Sebastianrmp/SIA_Extruder/Imagenes/PCB_DESIGN.jpeg

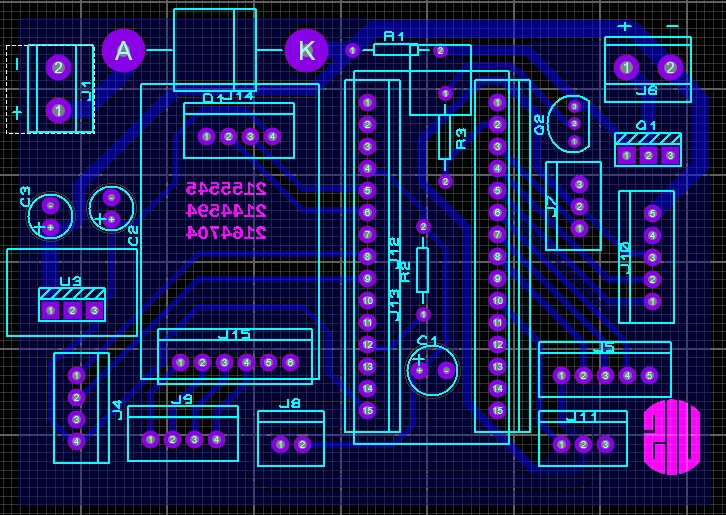
Imagenes/PCB_DESIGN.jpeg
