Sebastianrmp/SIA_Extruder/Imagenes/MONTAJE_FINAL_D.jpeg

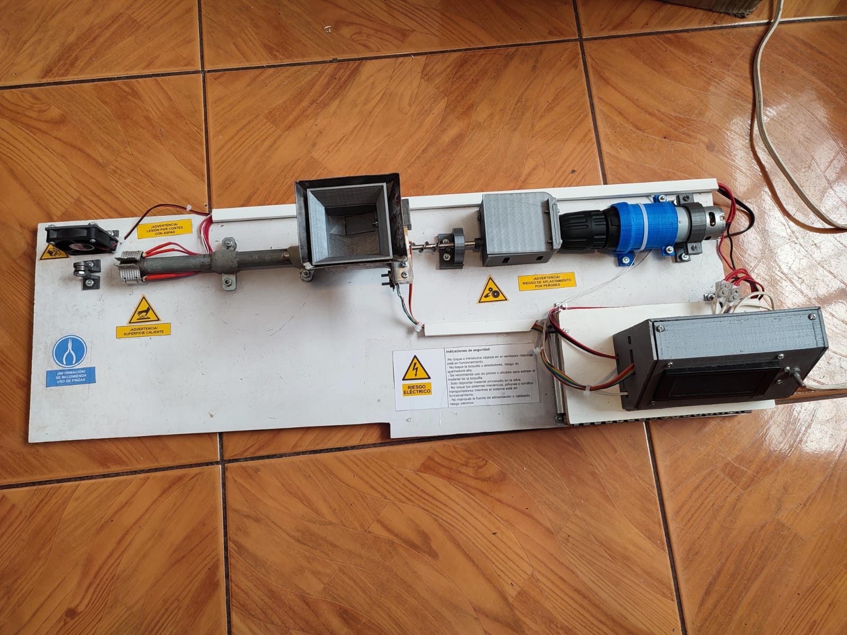
Imagenes/MONTAJE_FINAL_D.jpeg
