Sebastianrmp/SIA_Extruder/README.md

# Proyecto SIA Extruder
Project development for the SIA Extruder.
A add-on/extruder created by three Electronic Engineering students as a thesis project, based off of the idea of recycling plastic, either comercial or scraps from previous impressions to lower the impact the plastic has over the environment.
