Sebastianrmp/SIA_Extruder/Anexos/Extrusoras de Plástico .docx

Extrusoras de Plástico

En la industria, es muy común el uso de extrusoras de plástico para la elaboración de diversas piezas a partir de pellets, mediante la extrusión homogénea de plástico.

Las extrusoras se componen de un apartado de depósito de material, un apartado mecánico para el transporte y etapa de salida. El material pasa por una pieza que se calienta, dicha pieza tiene un orificio de salida por el cual el material fundido sale, ganando la forma del orificio.

Extrusión: la extrusión, es una técnica de fabricación mediante la fusión homogénea de termoplásticos.

Pellet: son pequeñas piezas de distintos materiales de un tamaño inferior a 5 mm, con forma irregular o esférica.

Existen varios tipos de extrusión de material plástico dentro de los cuales están:

Extrusión de tubería: El material triturado se deposita en una tolva sujeta a un ducto, dentro del cual hay un tornillo sin fin que transporta y compacta el material hasta el extremo donde se funde, dando así el resultado final .

Extrusión de película soplada: este método es muy popular, usado para la elaboración de bolsas o empaques, a diferencia de la extrusión de tubería, la salida pasa por un agujero que varía de unos centímetros a 3 metros, la cual pasa aire en medio

Extrusión de lámina:en este caso la salida del material fundido pasa por unos rodillos donde se enfría y estira para dejarlo como láminas.

Extrusión por-extrusión: este tipo de extrusión es usada para hacer recubrimiento plástico a cables, la salida tiene dos salidas que se unen una con el cable y la otra con el plástico.

Particularmente como las impresoras FDM usan filamento, por ello la manera de extrusión idónea es extrusión de tubería.

El material triturado se deposita en una tolva sujeta a un ducto, dentro del cual hay un tornillo sin fin que transporta y compacta el material hasta el extremo donde se funde y sale por un orificio, dando así como resultado un filamento del grosor del orificio.
