Sebastianrmp/SIA_Extruder/Imagenes/Driver.png

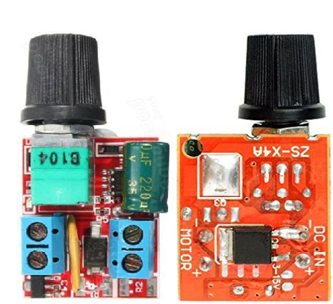
Imagenes/Driver.png
