Sebastianrmp/SIA_Extruder/Imagenes/IRFZ44N.jpeg

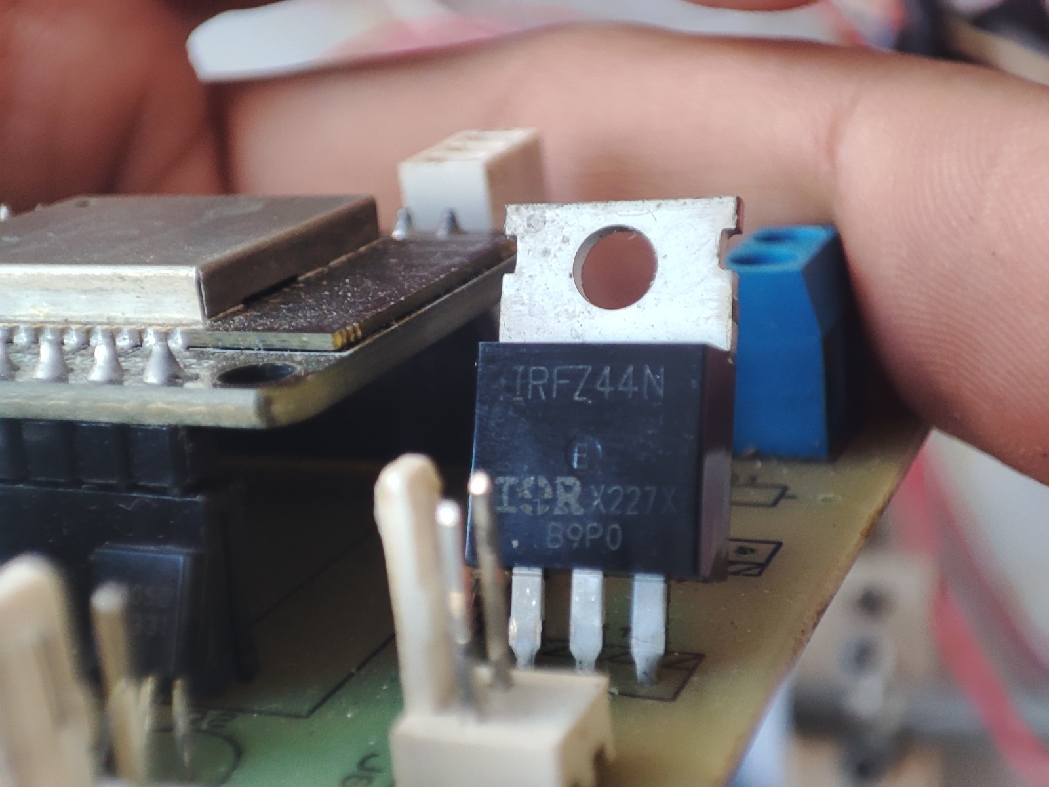
Imagenes/IRFZ44N.jpeg
