Sebastianrmp/SIA_Extruder/Imagenes/MEDIDOR_CORRIENTE.jpg

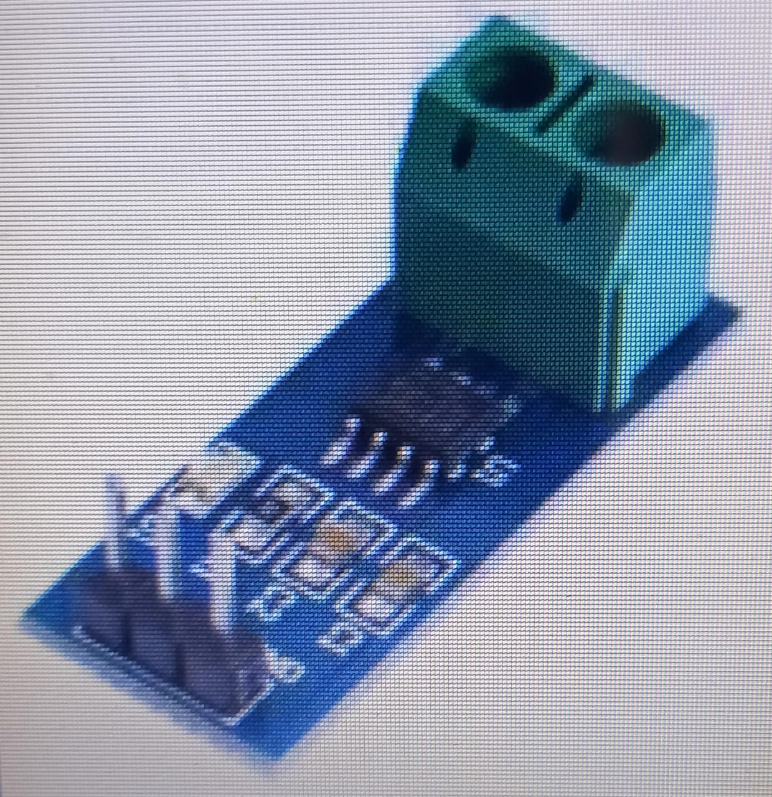
Imagenes/MEDIDOR_CORRIENTE.jpg
