Sebastianrmp/SIA_Extruder/Imagenes/PCB1.jpeg

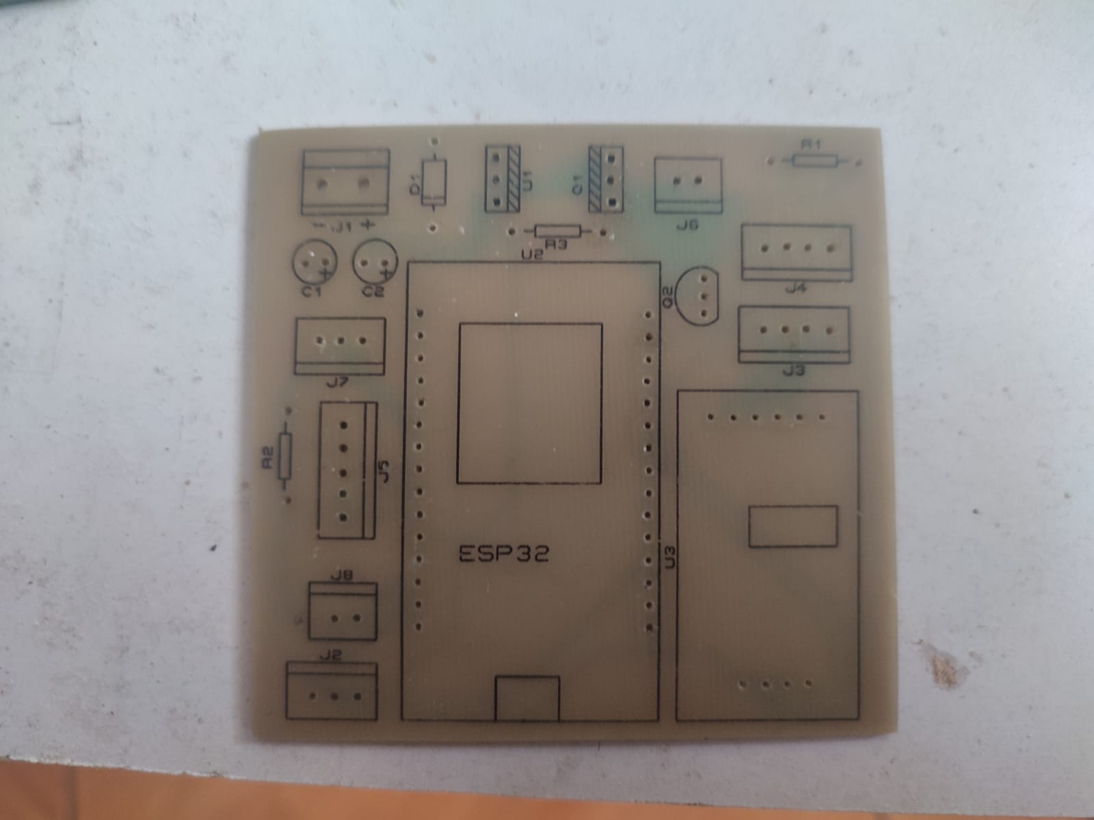
Imagenes/PCB1.jpeg
