Sebastianrmp/SIA_Extruder/Imagenes/PCB1_Montada.jpeg

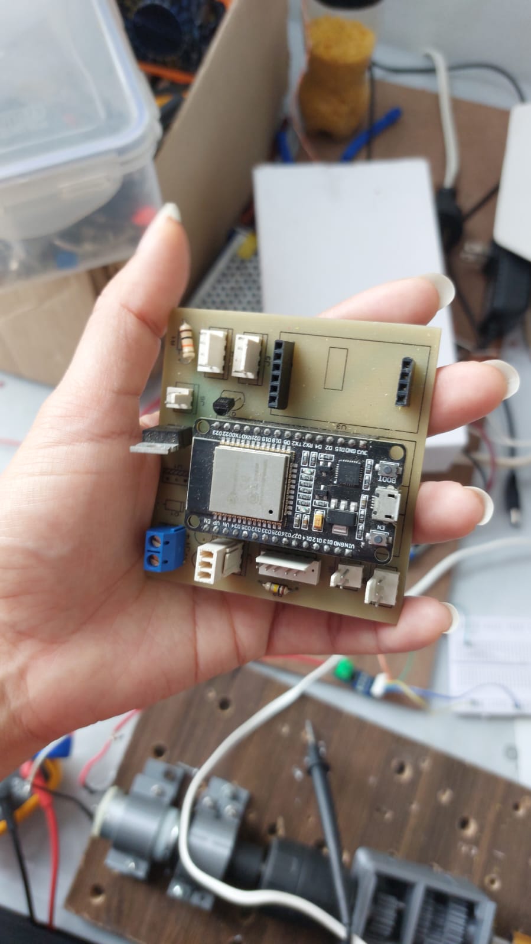
Imagenes/PCB1_Montada.jpeg
