Sebastianrmp/SIA_Extruder/Imagenes/PCB2.jpeg

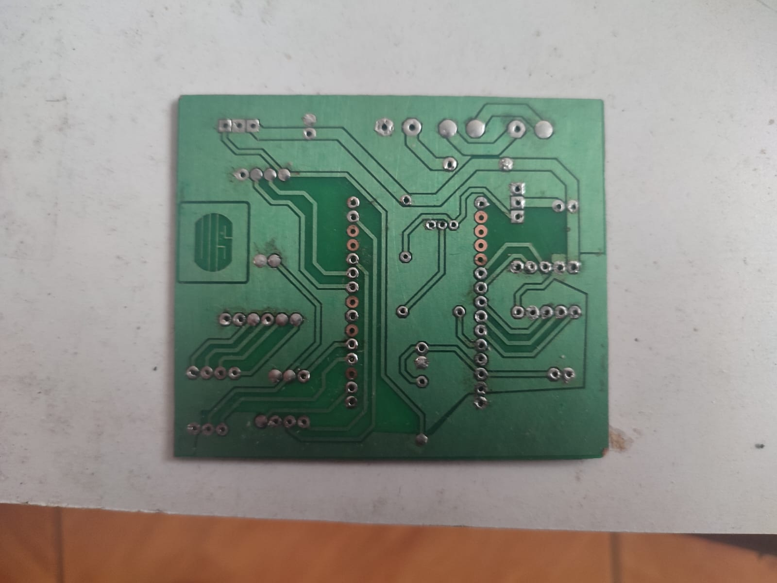
Imagenes/PCB2.jpeg
