Sebastianrmp/SIA_Extruder/Imagenes/PCB_FINAL.jpeg

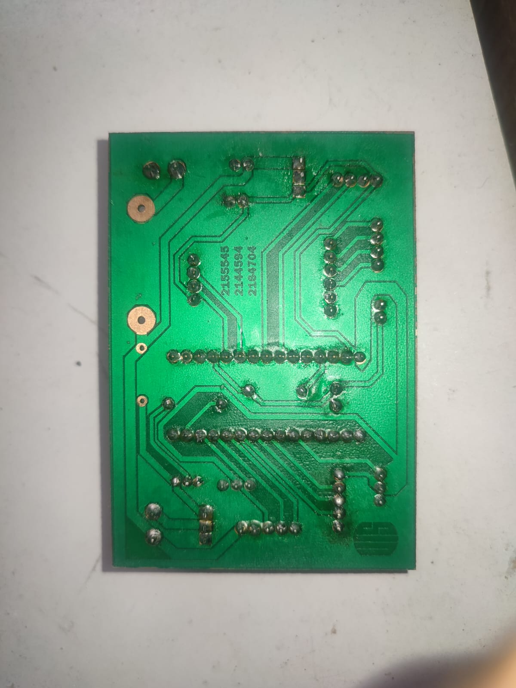
Imagenes/PCB_FINAL.jpeg
