Sebastianrmp/SIA_Extruder/Imagenes/S8050.jpeg

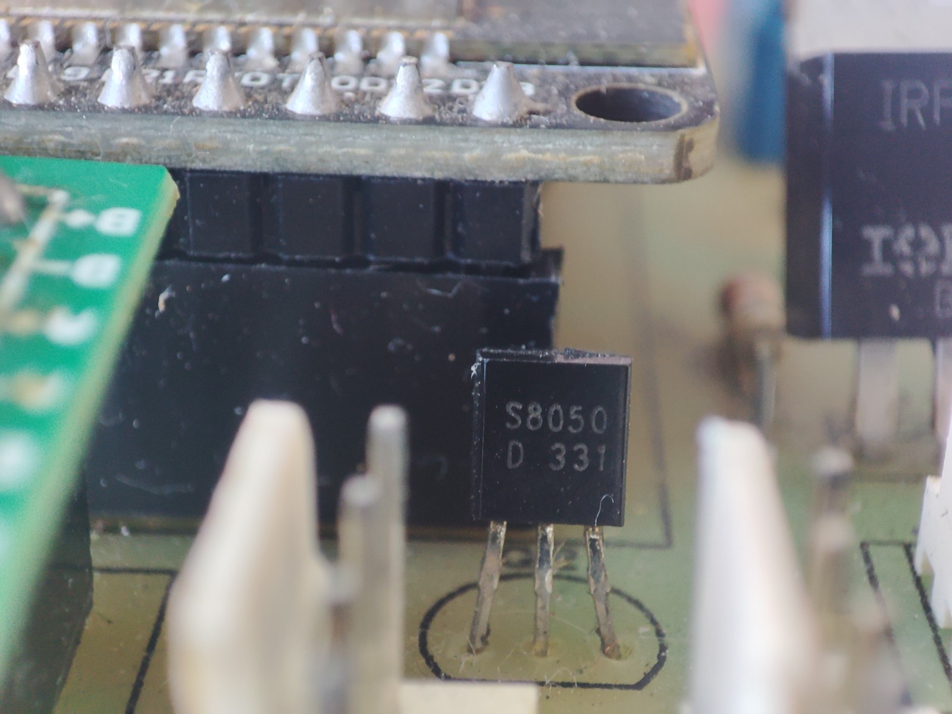
Imagenes/S8050.jpeg
