Sebastianrmp/SIA_Extruder/Scripts/Matlab/grafica_1.jpg

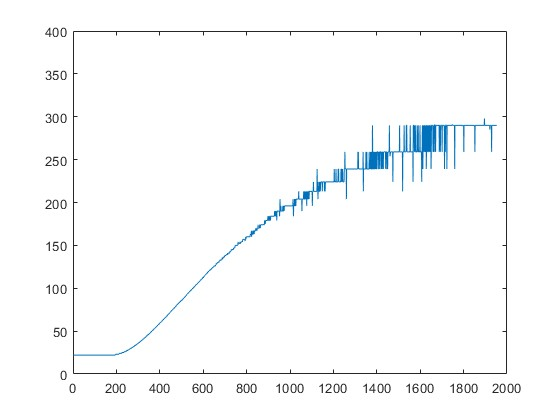
Scripts/Matlab/grafica_1.jpg
