Sebastianrmp/SIA_Extruder/Scripts/Matlab/grafica_2.jpg

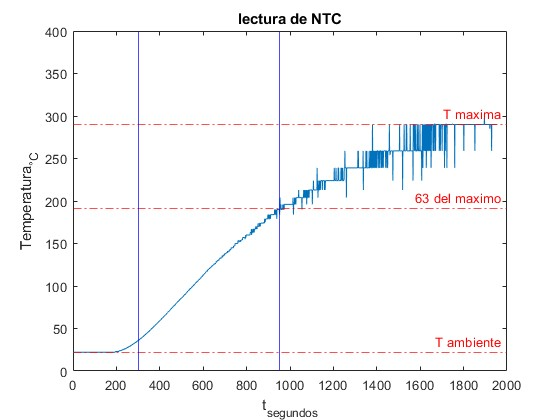
Scripts/Matlab/grafica_2.jpg
