Sebastianrmp/SIA_Extruder/Scripts/Matlab/grafica_3.jpg

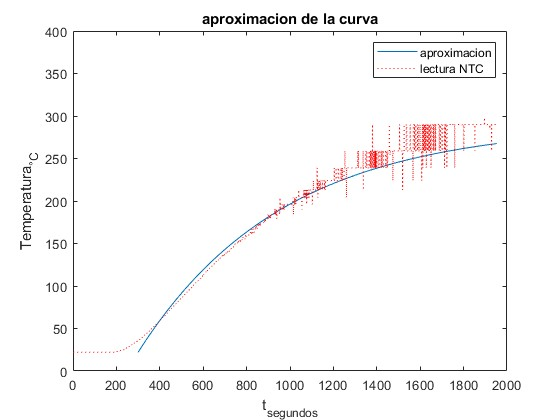
Scripts/Matlab/grafica_3.jpg
