Sebastianrmp/SIA_Extruder/Scripts/Matlab/grafica_4.jpg

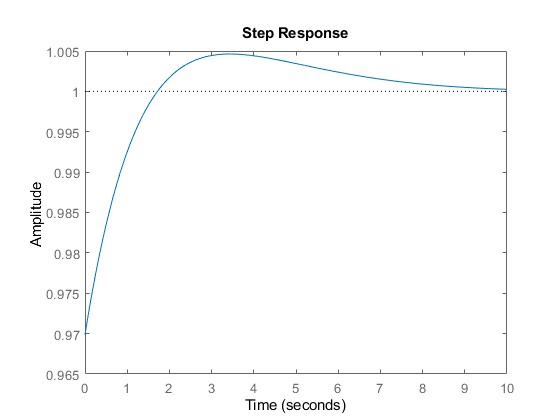
Scripts/Matlab/grafica_4.jpg
