Sebastianrmp/SIA_Extruder/Scripts/Matlab/grafica_4_1.jpg

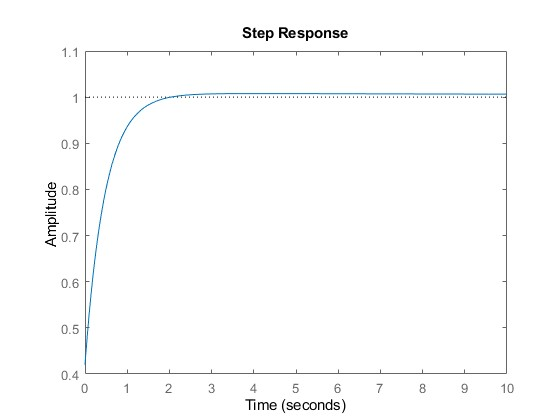
Scripts/Matlab/grafica_4_1.jpg
