Sebastianrmp/SIA_Extruder/Scripts/Matlab/grafica_5.jpg

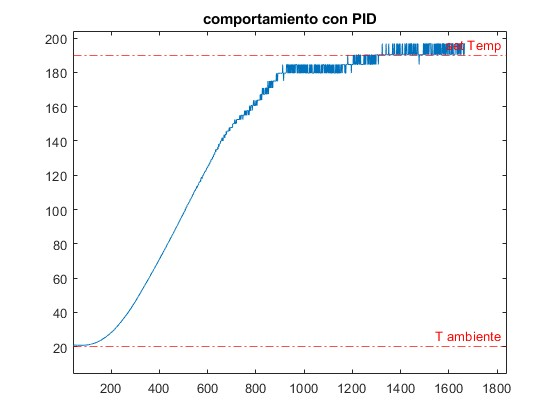
Scripts/Matlab/grafica_5.jpg
