Sebastianrmp/SIA_Extruder/Imagenes/MONTAJE_FINAL.jpeg

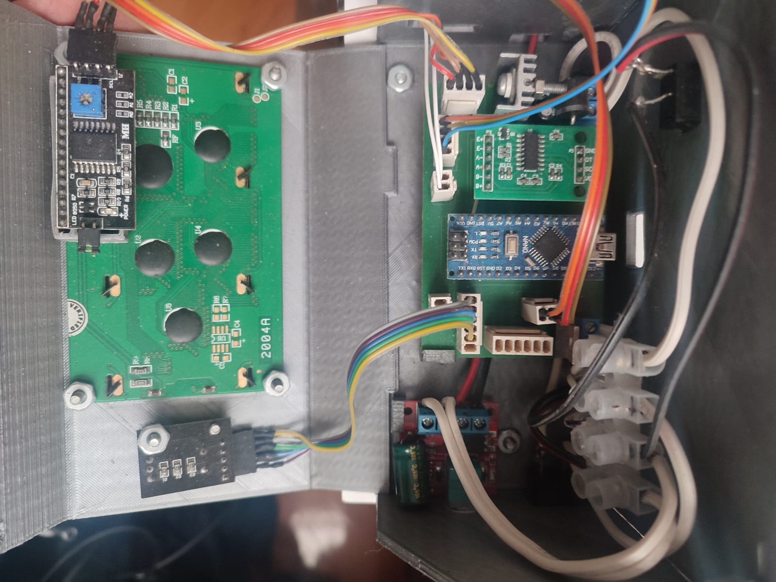
Imagenes/MONTAJE_FINAL.jpeg
