Sebastianrmp/SIA_Extruder/Imagenes/MONTAJE_FINAL_A.jpeg

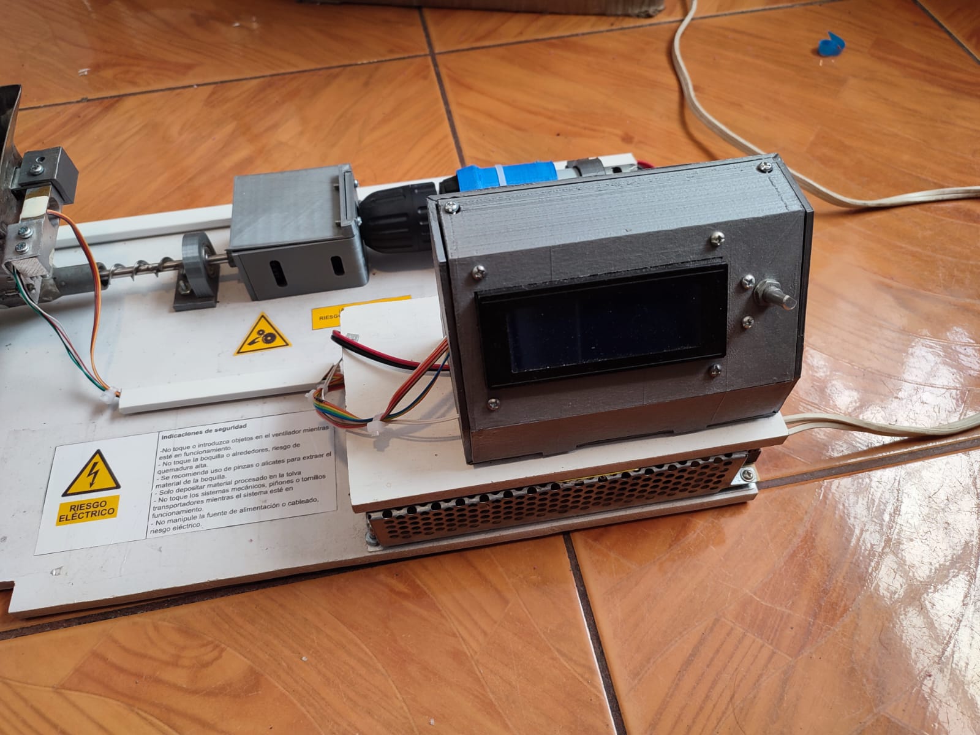
Imagenes/MONTAJE_FINAL_A.jpeg
