Sebastianrmp/SIA_Extruder/Imagenes/MONTAJE_FINAL_B.jpeg

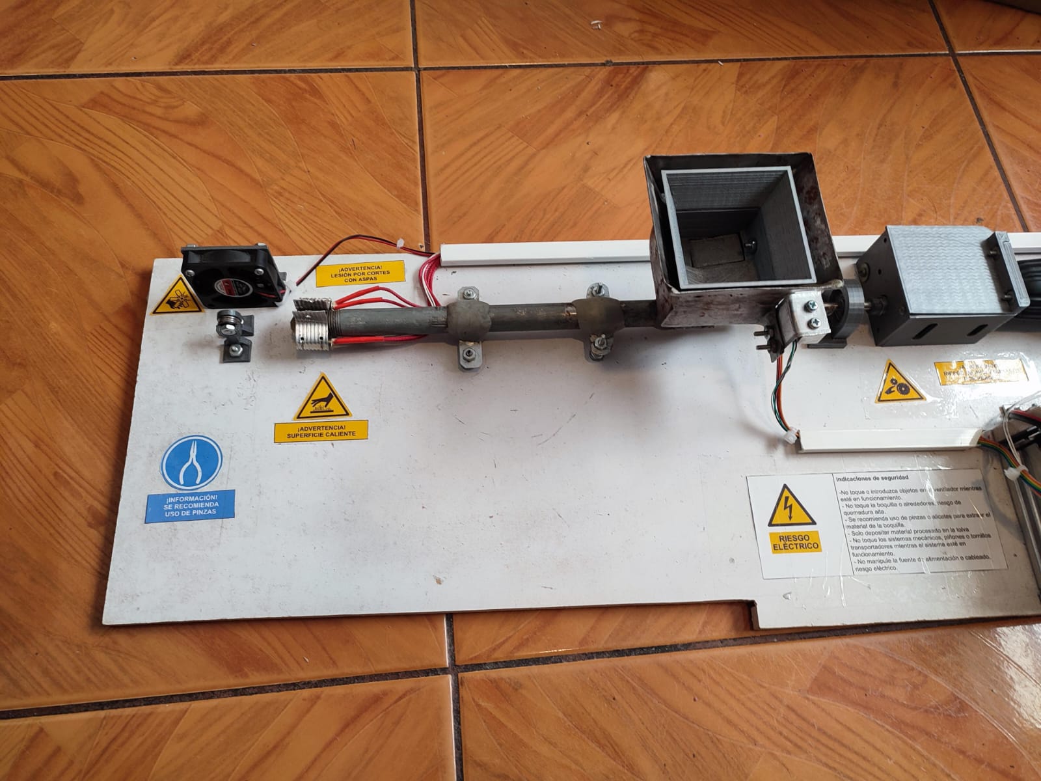
Imagenes/MONTAJE_FINAL_B.jpeg
