Sebastianrmp/SIA_Extruder/Imagenes/MONTAJE_FINAL_C.jpeg

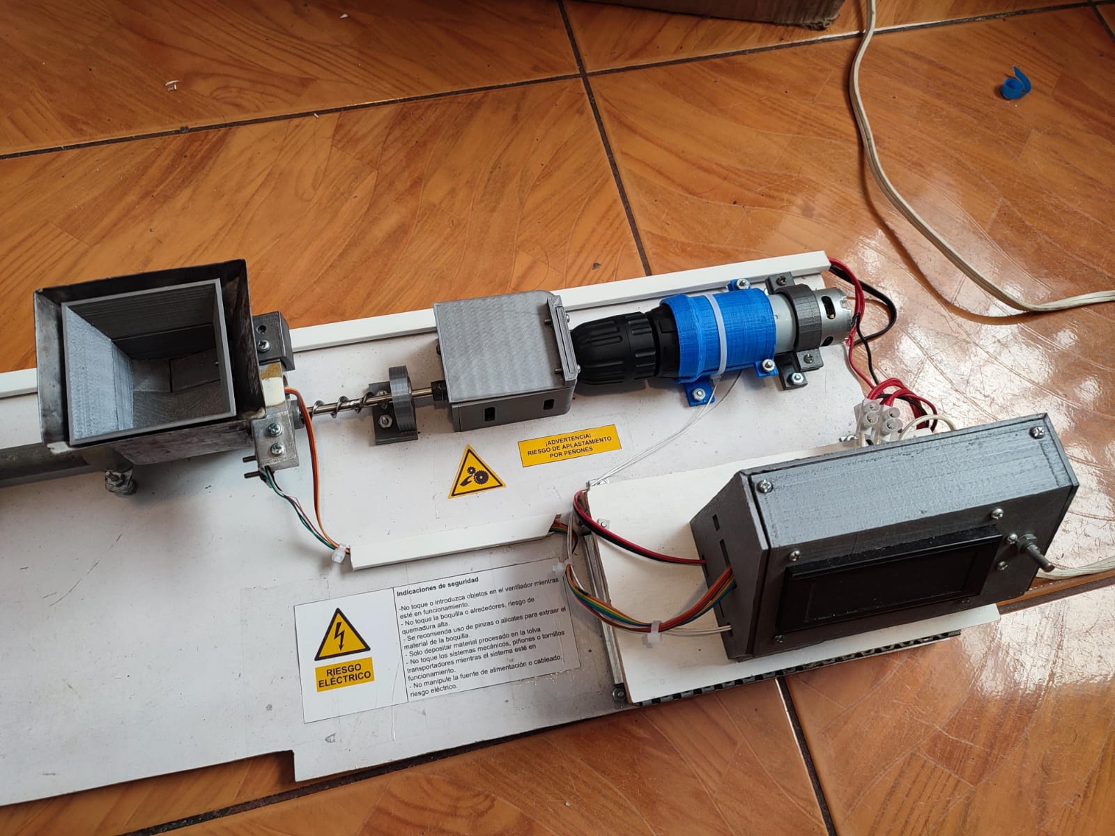
Imagenes/MONTAJE_FINAL_C.jpeg
