Sebastianrmp/SIA_Extruder/Dispositivos/pcb.PDF

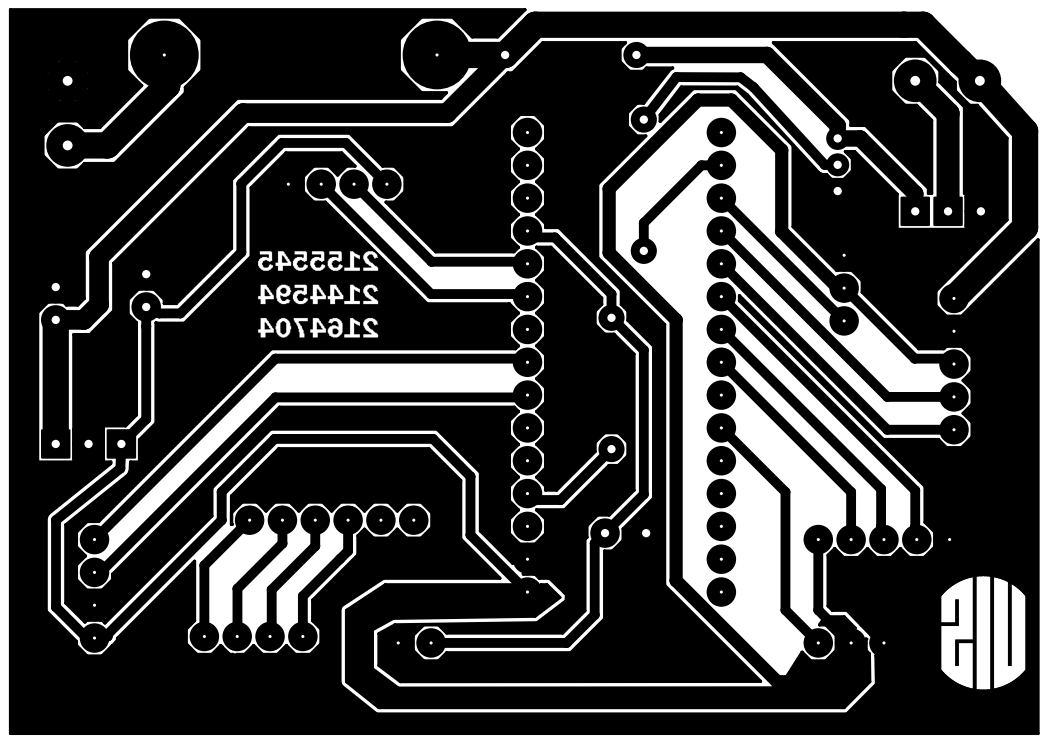
[picture p50: page 1]
