Sebastianrmp/SIA_Extruder/Dispositivos/pcb_drill.PDF

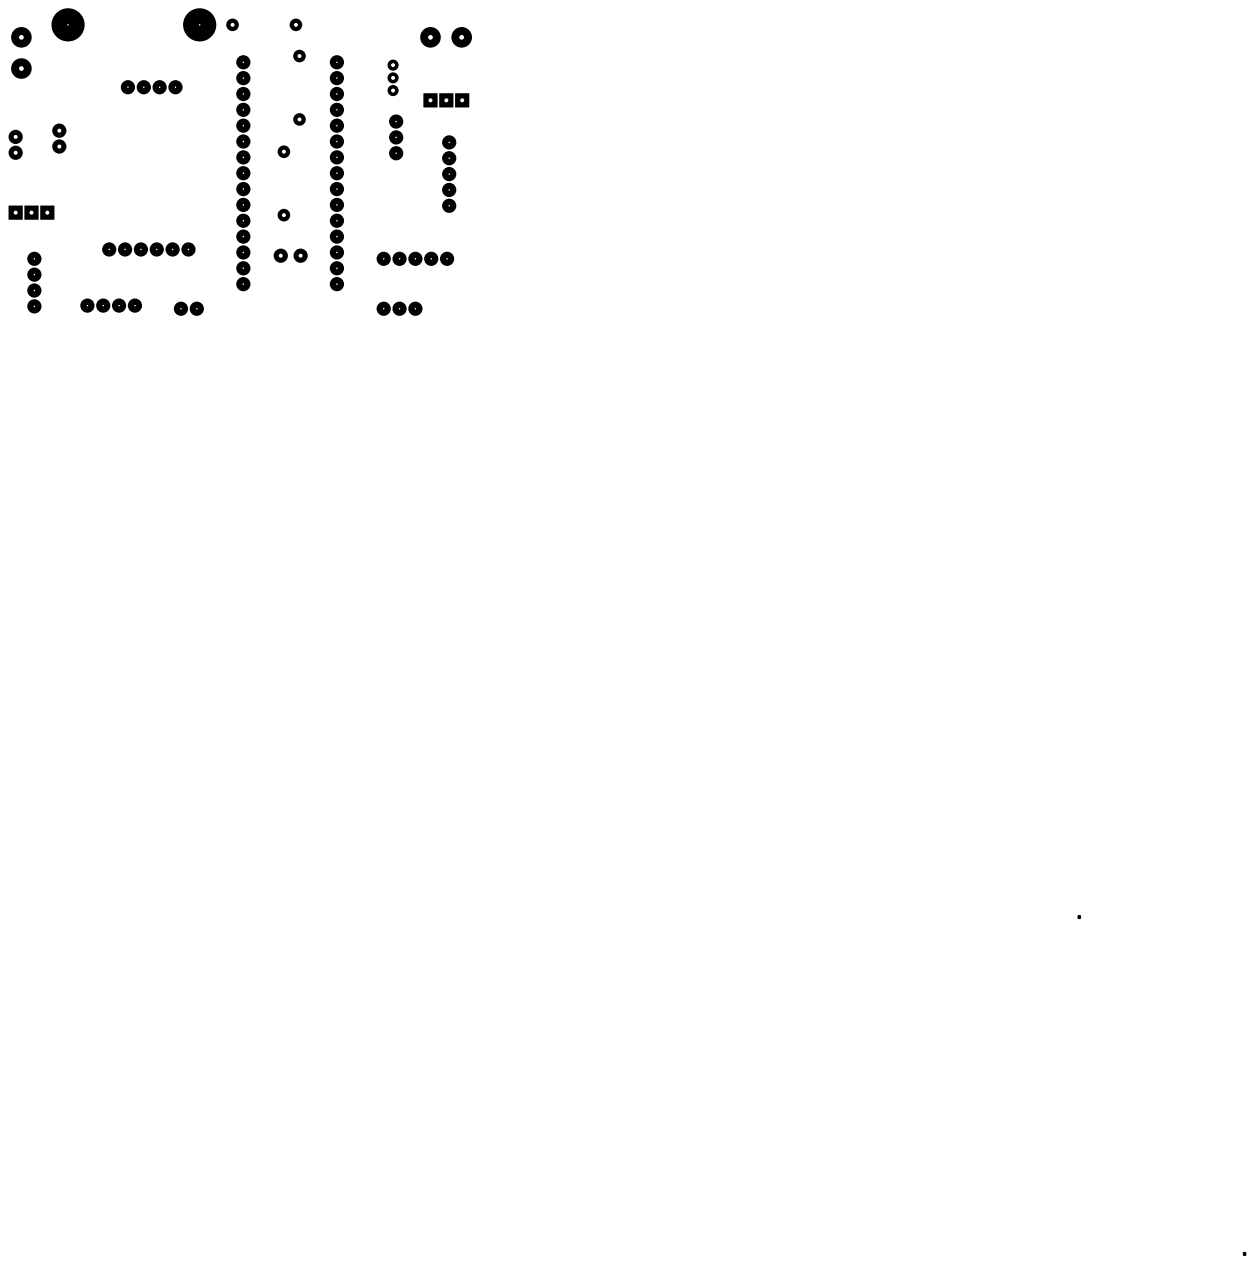
[picture p51: page 1]
