Sebastianrmp/SIA_Extruder/Dispositivos/pcb_masks.PDF

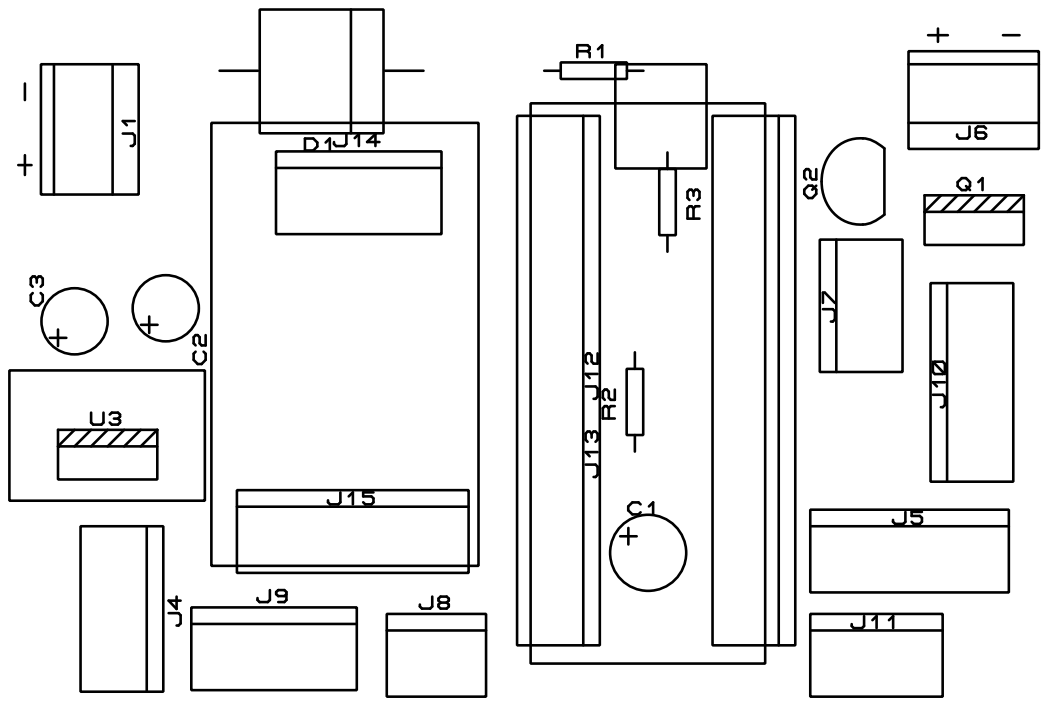
[picture p52: page 1]
