Sebastianrmp/SIA_Extruder/(commit log)

2025-09-06 Add files via upload
    esta es la version del script que no contiene el sensor de peso y aun no esta probado el PID
2026-01-09 Create Extrusoras de Plástico .docx
2026-01-09 Cambio de nombre
